vsotoc666/CubeSat-1U---TelEctroSat/(list of files, cad)

Other CAD files:
cad/eps_diseno_v1.dwg
cad/modelo_prueba.dwg
cad/modelo_borrador.dwg
cad/modelo_inicial.dwg
